ttahsin-bey/C64-Joystick-Switcher/export/C64 Joystick Switcher.pdf

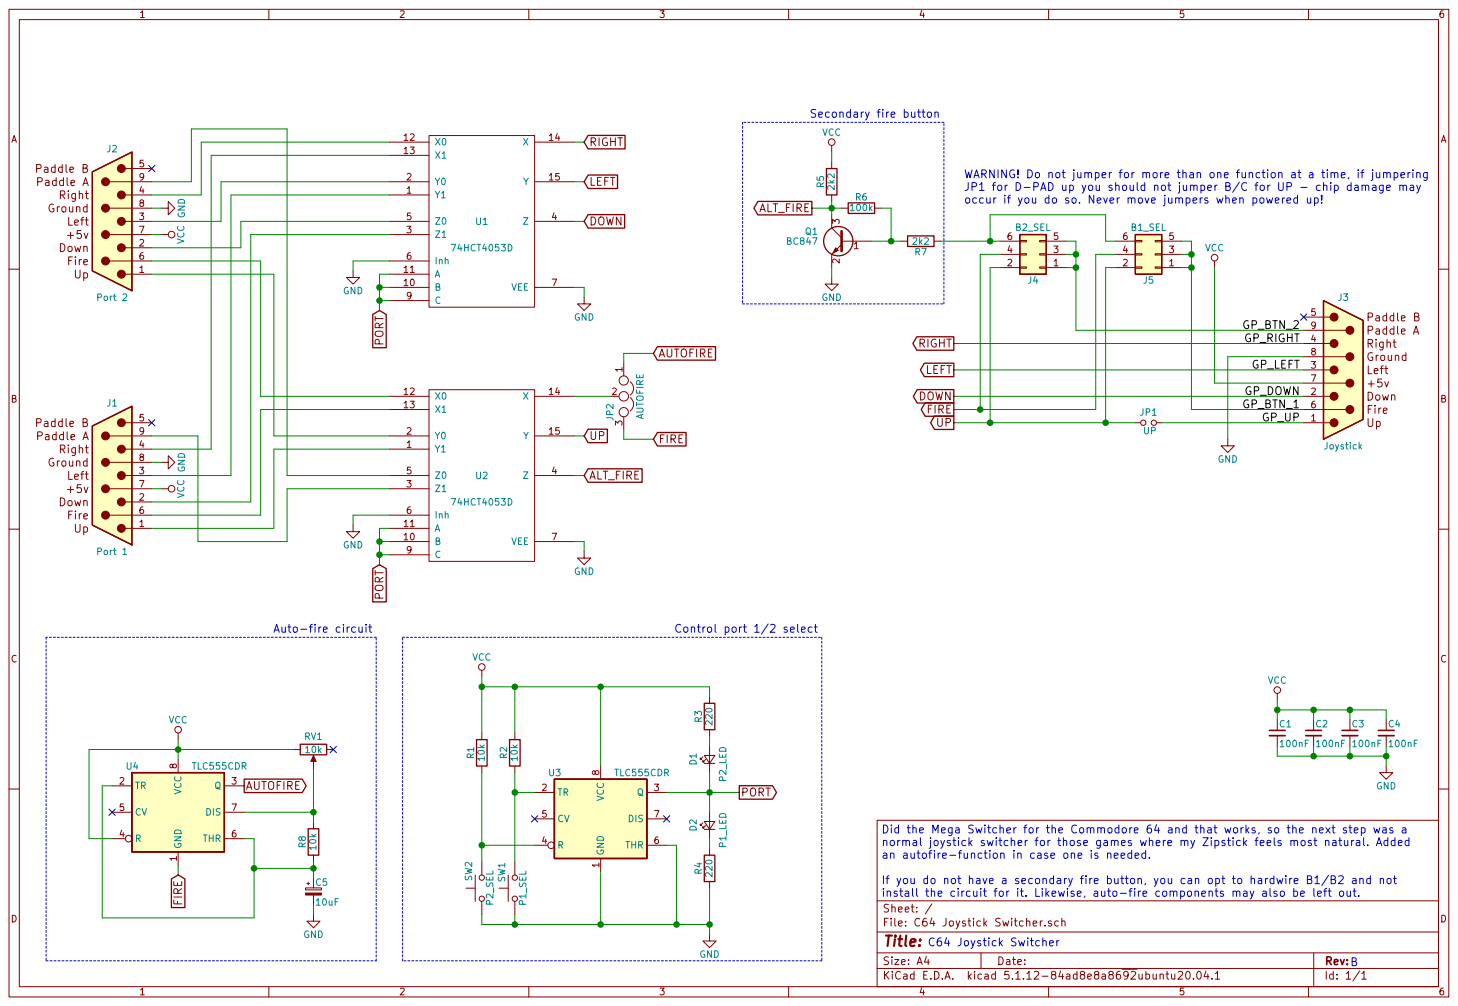
[picture p1: page 1]

WARNING! Do not jumper for more than one function at a time, if jumpering
JP1 for D-PAD up you should not jumper B/C for UP - chip damage may

J4 B2_SEL GND VCC VCC GND

Did the Mega Switcher for the Commodore 64 and that works, so the next step was a
normal joystick switcher for those games where my Zipstick feels most natural. Added
an autofire-function in case one is needed.

If you do not have a secondary fire button, you can opt to hardwire B1/B2 and not
install the circuit for it. Likewise, auto-fire components may also be left out.
File: C64 Joystick Switcher.sch Sheet: /
Id: 1/1 Title:
