ttahsin-bey/C64-Joystick-Switcher/C64 Joystick Switcher.kicad_pcb

## KiCad design C64 Joystick Switcher.kicad_pcb (2021-12-19)

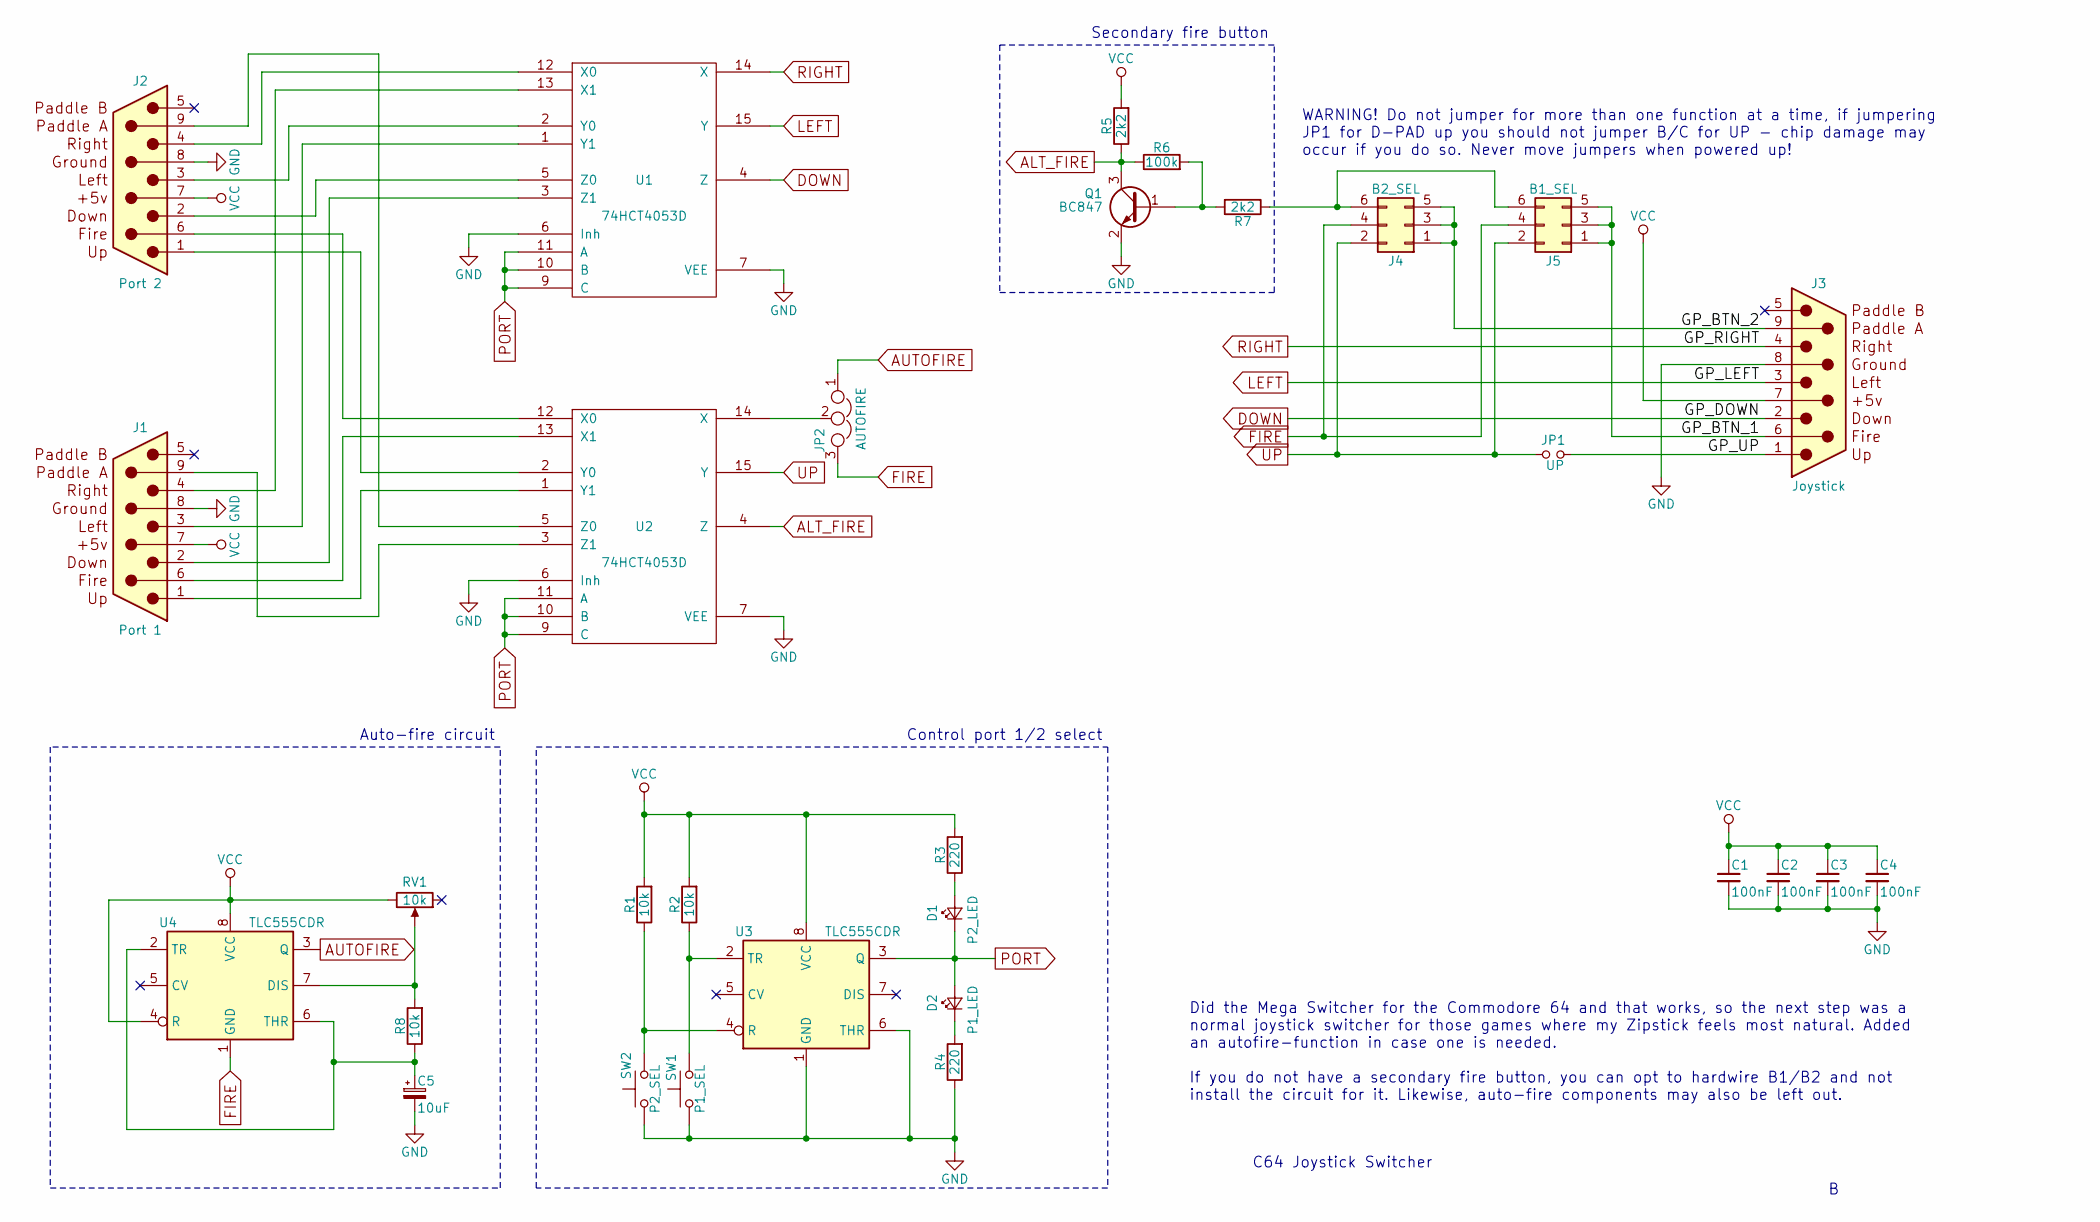
[picture p2: schematic C64 Joystick Switcher.sch]

Parts:
C1, C2, C3, C4: 100nF; C_0603_1608Metric; JLCPCB C14663
C5: 10uF; CP_EIA-3216-18_Kemet-A; JLCPCB C7171
D1: P2_LED; LED_0603_1608Metric; JLCPCB C2286
D2: P1_LED; LED_0603_1608Metric; JLCPCB C2286
J1: Port 1; DSUB-9_Female_Horizontal_P2.77x2.84mm_EdgePinOffset7.70mm_H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
J2: Port 2; DSUB-9_Female_Horizontal_P2.77x2.84mm_EdgePinOffset7.70mm_H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
J3: Joystick; DSUB-9_Male_Horizontal_P2.77x2.84mm_EdgePinOffset7.70mm_Hou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
J4: B2_SEL; Pin_Header_Straight_2x03_Pitch2.54mm
J5: B1_SEL; Pin_Header_Straight_2x03_Pitch2.54mm
JP1: UP; Pin_Header_Straight_1x02_Pitch2.54mm
JP2: AUTOFIRE; Pin_Header_Straight_1x03_Pitch2.54mm
Q1: BC847; SOT-23; JLCPCB C57668
R1, R2, R8: 10k; R_0603_1608Metric; JLCPCB C25804
R3, R4: 220; R_0603_1608Metric; JLCPCB C22962
R5, R7: 2k2; R_0603_1608Metric; JLCPCB C4190
R6: 100k; R_0603_1608Metric; JLCPCB C25803
RV1: 10k; Potentiometer_Piher_PT-6-V_Vertical
SW1: P1_SEL; SW_Tactile_SPST_Angled_PTS645Vx58-2LFS
SW2: P2_SEL; SW_Tactile_SPST_Angled_PTS645Vx58-2LFS
U1, U2: 74HCT4053D; SO-16_3.9x9.9mm_P1.27mm; JLCPCB C5996
U3, U4: TLC555CDR; SO-8_3.9x4.9mm_P1.27mm; JLCPCB C6986

Connections:
/GP_BTN_1: J3.6, J5.1, J5.3, J5.5
/GP_BTN_2: J3.9, J4.1, J4.3, J4.5
/GP_UP: J3.1, JP1.2
ALT_FIRE: Q1.3 (C), R5.1, R6.1, U2.4 (Z)
AUTOFIRE: JP2.1, U4.3 (Q)
DOWN: J3.2, U1.4 (Z)
FIRE: J4.4, J5.4, JP2.3, U4.1 (GND)
GND: C1.2, C2.2, C3.2, C4.2, C5.2, J1.8 (GND), J2.8 (GND), J3.8 (GND), Q1.2 (E), R4.1, SW1.2, SW2.1, U1.6 (Inh), U1.7 (VEE), U1.8 (GND), U2.6 (Inh), U2.7 (VEE), U2.8 (GND), U3.1 (GND), U3.6 (THR)
LEFT: J3.3, U1.15 (Y)
unnamed: C5.1, R8.1, U4.2 (TR), U4.6 (THR)
unnamed: D1.2 (A), R3.1
unnamed: D2.1 (K), R4.2
unnamed: J1.1, U2.1 (Y1)
unnamed: J1.2, U1.3 (Z1)
unnamed: J1.3, U1.1 (Y1)
unnamed: J1.4, U1.13 (X1)
unnamed: J1.6, U2.13 (X1)
unnamed: J1.9, U2.3 (Z1)
unnamed: J2.1, U2.2 (Y0)
unnamed: J2.2, U1.5 (Z0)
unnamed: J2.3, U1.2 (Y0)
unnamed: J2.4, U1.12 (X0)
unnamed: J2.6, U2.12 (X0)
unnamed: J2.9, U2.5 (Z0)
unnamed: J4.6, J5.6, R7.1
unnamed: JP2.2, U2.14 (X)
unnamed: Q1.1 (B), R6.2, R7.2
unnamed: R1.1, SW2.2, U3.4 (R)
unnamed: R2.1, SW1.1, U3.2 (TR)
unnamed: R8.2, RV1.2, U4.7 (DIS)
PORT: D1.1 (K), D2.2 (A), U1.9 (C), U1.10 (B), U1.11 (A), U2.9 (C), U2.10 (B), U2.11 (A), U3.3 (Q)
RIGHT: J3.4, U1.14 (X)
UP: J4.2, J5.2, JP1.1, U2.15 (Y)
VCC: C1.1, C2.1, C3.1, C4.1, J1.7 (VCC), J2.7 (VCC), J3.7 (VCC), R1.2, R2.2, R3.2, R5.2, RV1.3, U1.16 (VCC), U2.16 (VCC), U3.8 (VCC), U4.4 (R), U4.8 (VCC)

Notes on the sheet:
C64 Joystick Switcher
WARNING! Do not jumper for more than one function at a time, if jumpering JP1 for D-PAD up you should not jumper B/C for UP - chip damage may occur if you do so. Never move jumpers when powered up!
Did the Mega Switcher for the Commodore 64 and that works, so the next step was a normal joystick switcher for those games where my Zipstick feels most natural. Added an autofire-function in case one is needed. If you do not have a secondary fire button, you can opt to hardwire B1/B2 and not instal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
Auto-fire circuit
Control port 1/2 select
Secondary fire button

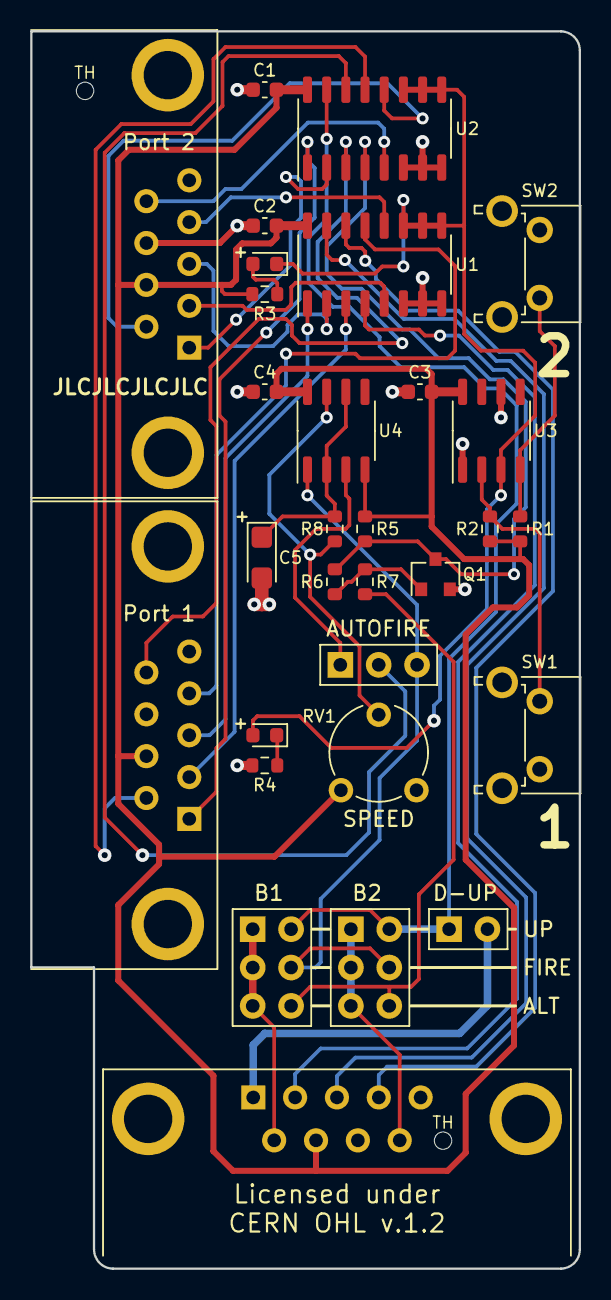
[picture p3: board C64 Joystick Switcher.kicad_pcb from above]

Board: 2 copper layers, 36.3 x 81.9 mm, 32 parts (0 on the bottom side), 34 nets.

Other parts of the board:
TH: Tooling Hole 1,1mm; MountingHole_2.1mm
TH#2: Tooling Hole 1,1mm; MountingHole_2.1mm
