ttahsin-bey/C64-Joystick-Switcher/(notices)

Notices in the files:
C64 Joystick Switcher.kicad_pcb:
Licensed under
CERN OHL v.1.2
